boryspimpek/Hexapod/media/1.png

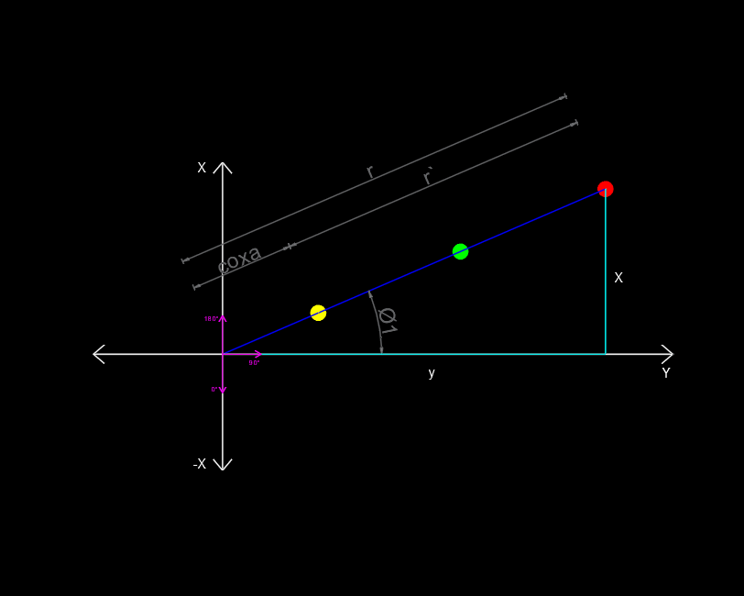
media/1.png
