boryspimpek/Hexapod/media/2.png

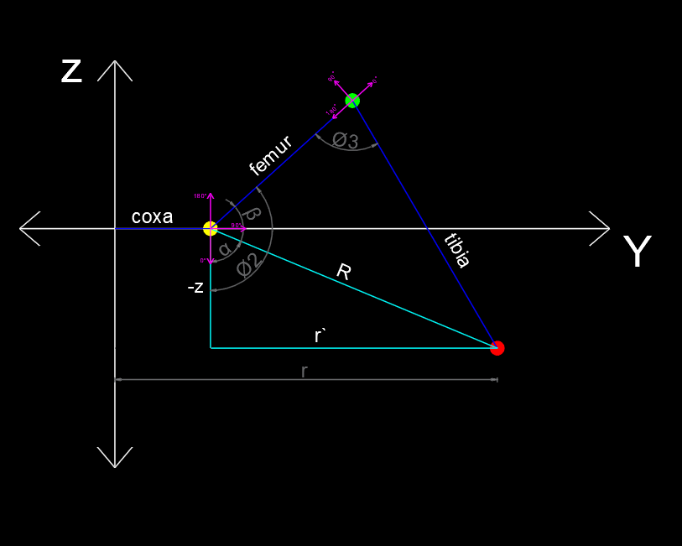
media/2.png
