boryspimpek/Hexapod/media/4.png

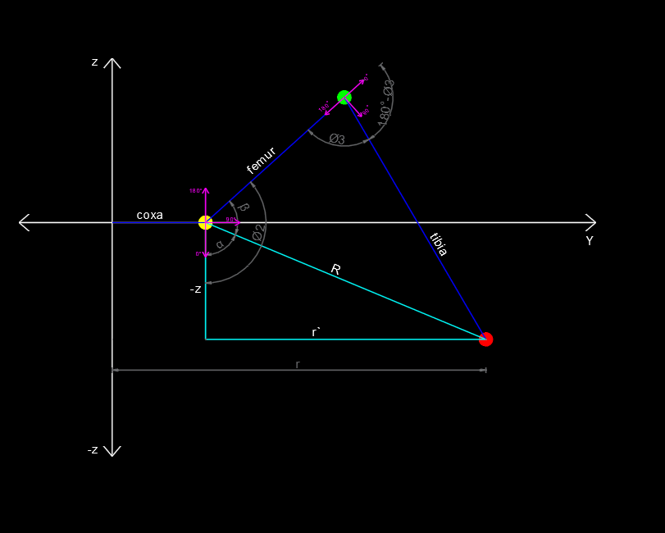
media/4.png
