boryspimpek/Hexapod/media/below2.png

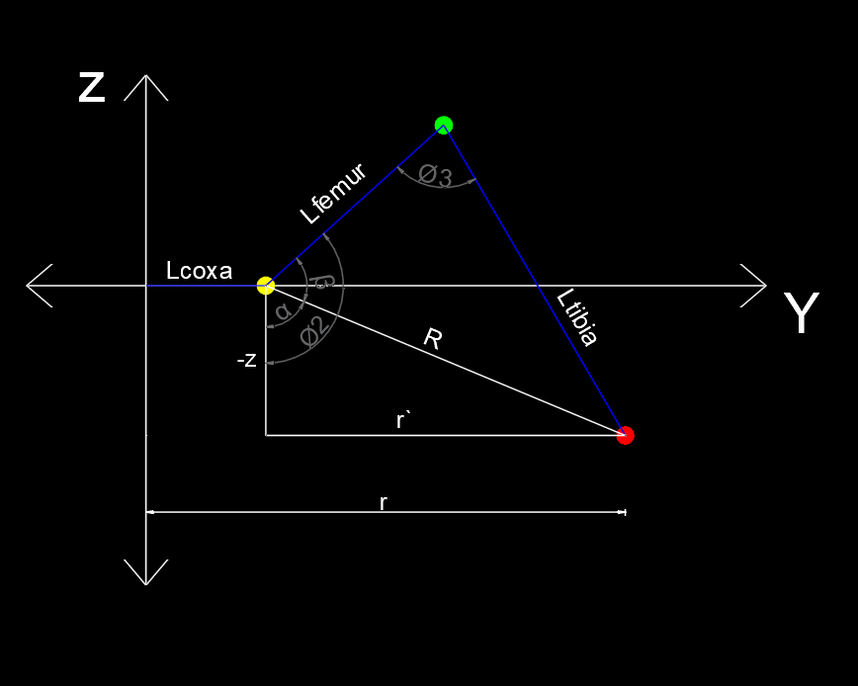
media/below2.png
