boryspimpek/Hexapod/media/below3.png

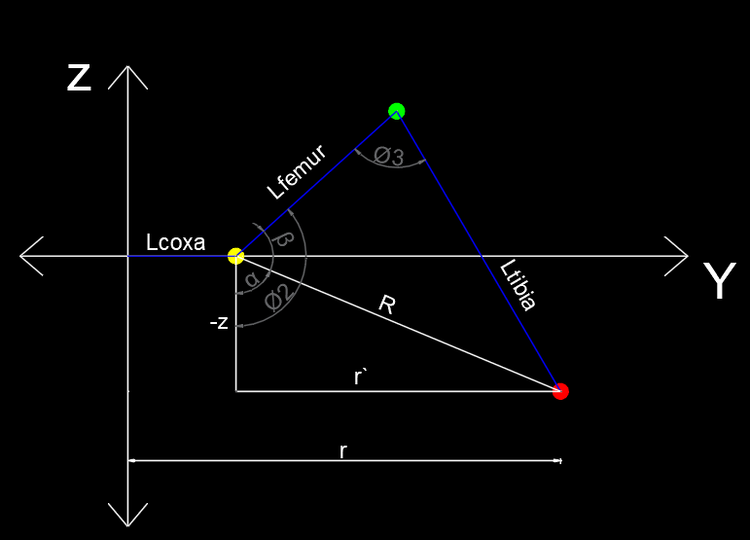
media/below3.png
