boryspimpek/Hexapod/media/below.png

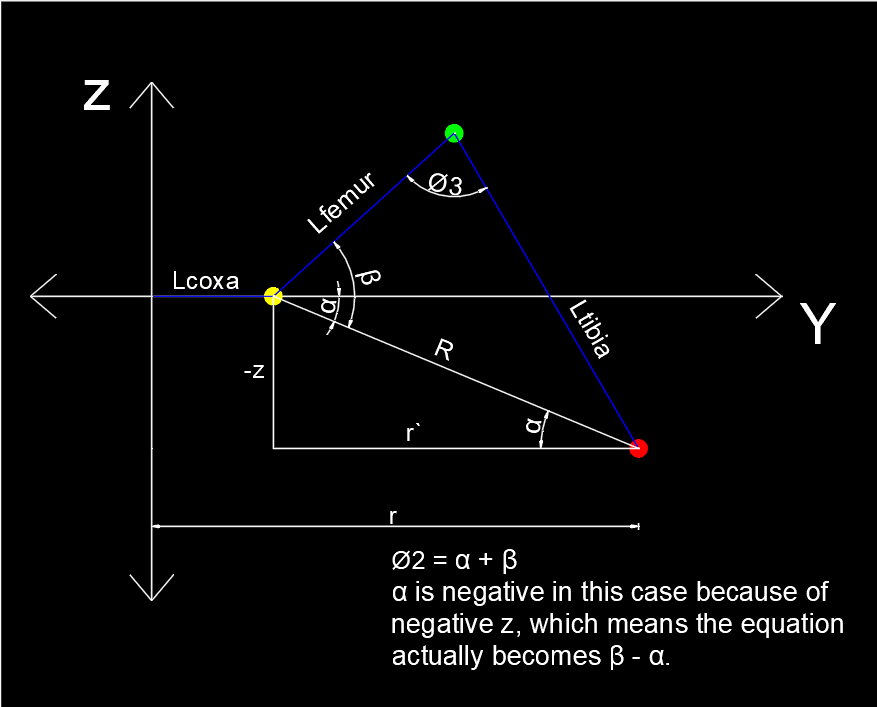
media/below.png
