boryspimpek/Hexapod/media/front_view_1.png

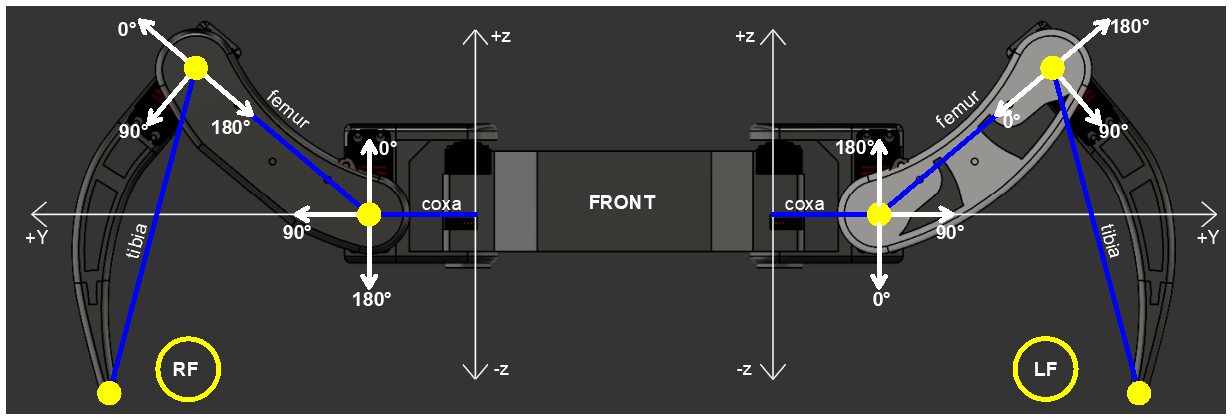
media/front_view_1.png
