boryspimpek/Hexapod/media/Zrzut ekranu 2026-09-11 193820.png

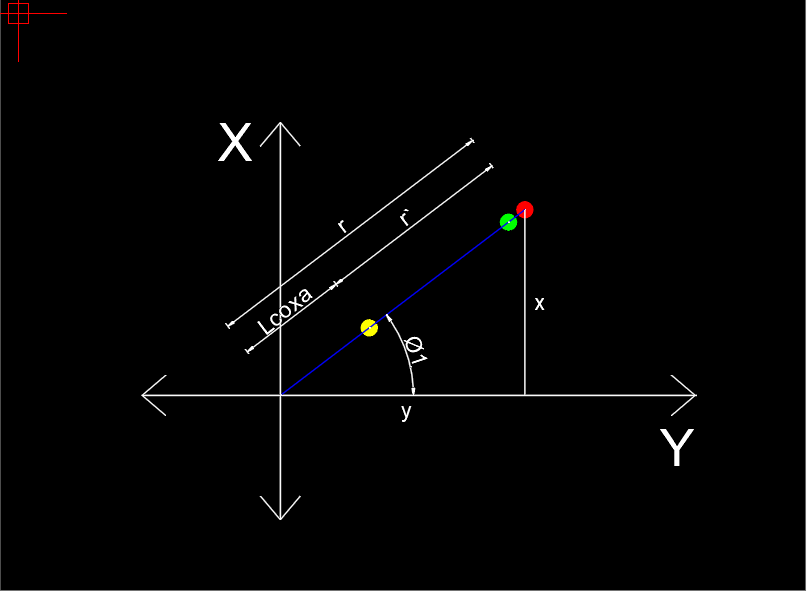
media/Zrzut ekranu 2026-09-11 193820.png
