boryspimpek/Hexapod/media/Zrzut ekranu 2026-09-11 193857.png

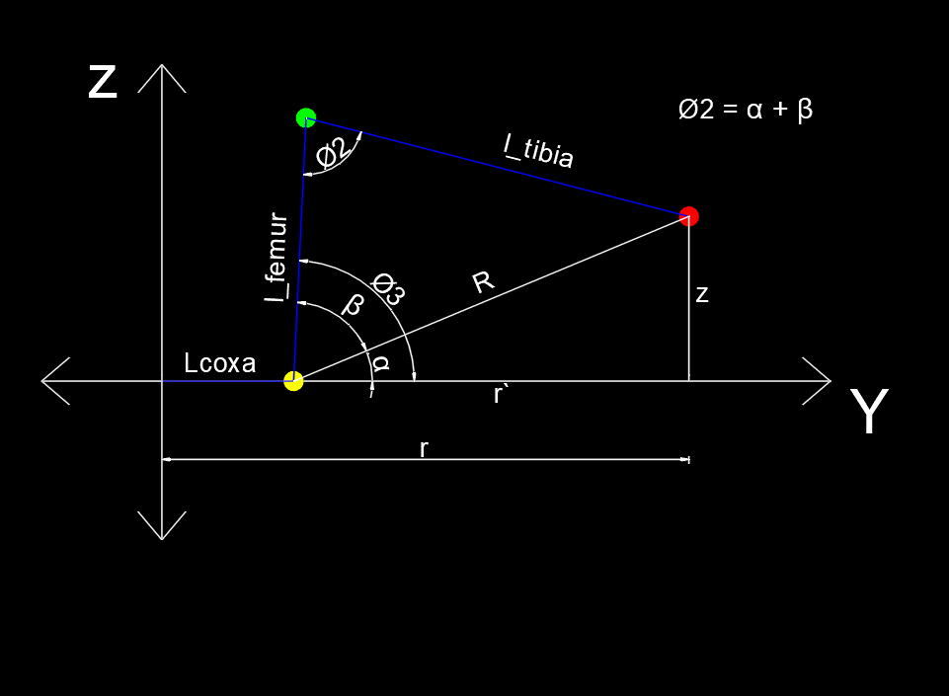
media/Zrzut ekranu 2026-09-11 193857.png
