boryspimpek/Hexapod/trash/simulator-after.png

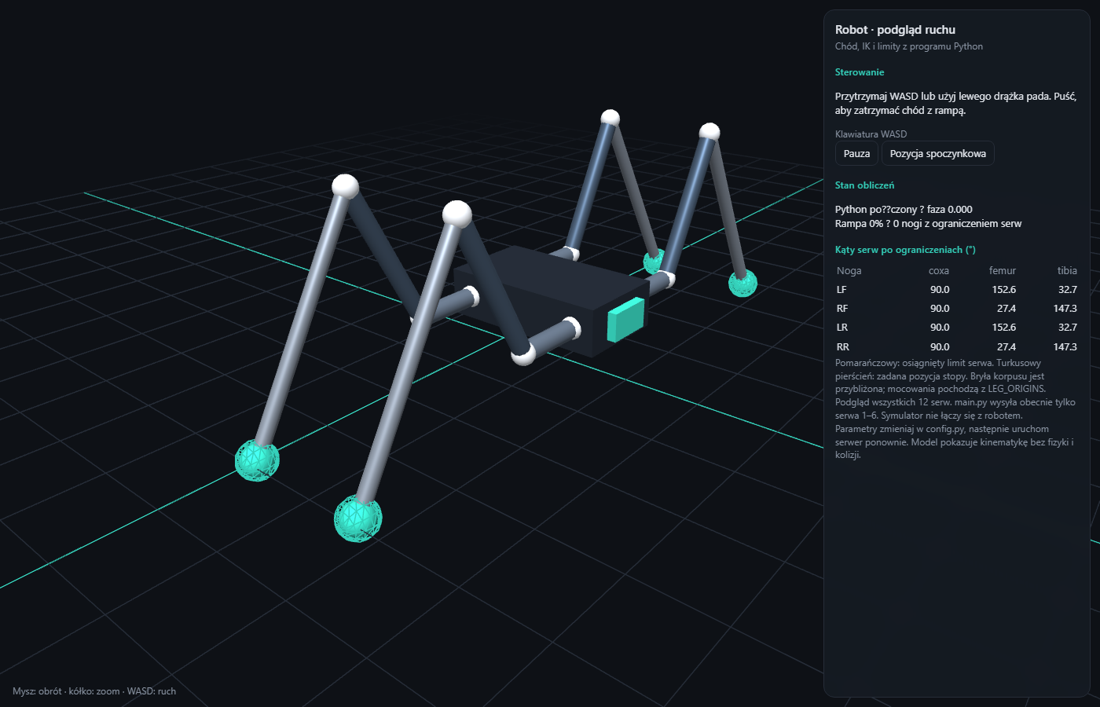
trash/simulator-after.png
