boryspimpek/Hexapod/(commit log)

2026-09-13 inverse servo mount
2026-09-30 servo control
    [cycle.csv]
2026-09-30 print angles
    [cycle.csv]
2026-09-30 neutral angeles
    [cycle.csv]
2026-09-30 plot angeles
    [cycle.csv]
